jacobantoun/Christmas-Ornament-2024/3D/PTS815 Series.stp

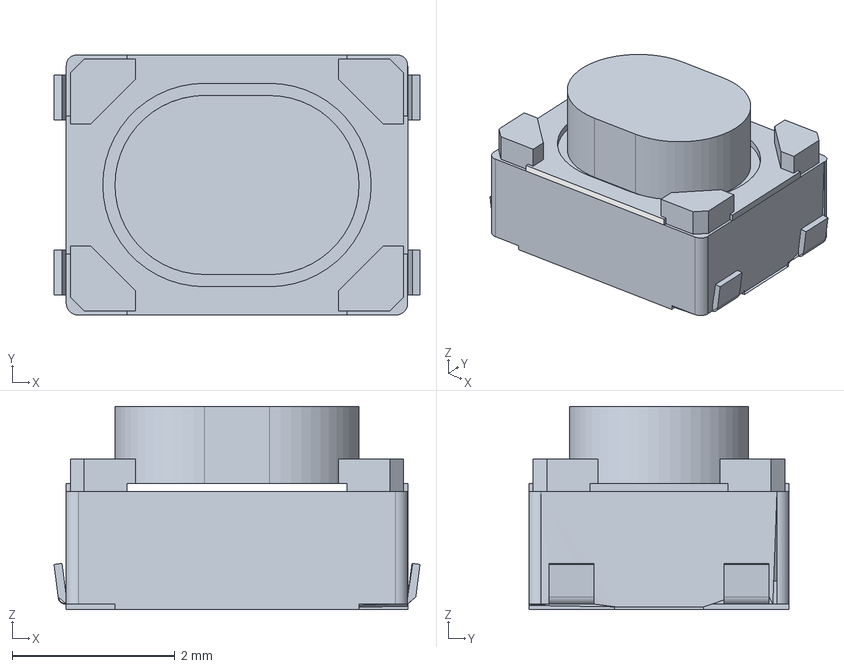
[picture p1: CAD file, 2024-11-22]
3D/PTS815 Series.stp
4.50 x 3.20 x 2.50 mm
PTS815SJM250SMTRLFS_PART1
PTS815SJM250SMTRLFS_PART2
PTS815SJM250SMTRLFS_PART3
