jacobantoun/Christmas-Ornament-2024/Christmas Ornament 2024.pdf

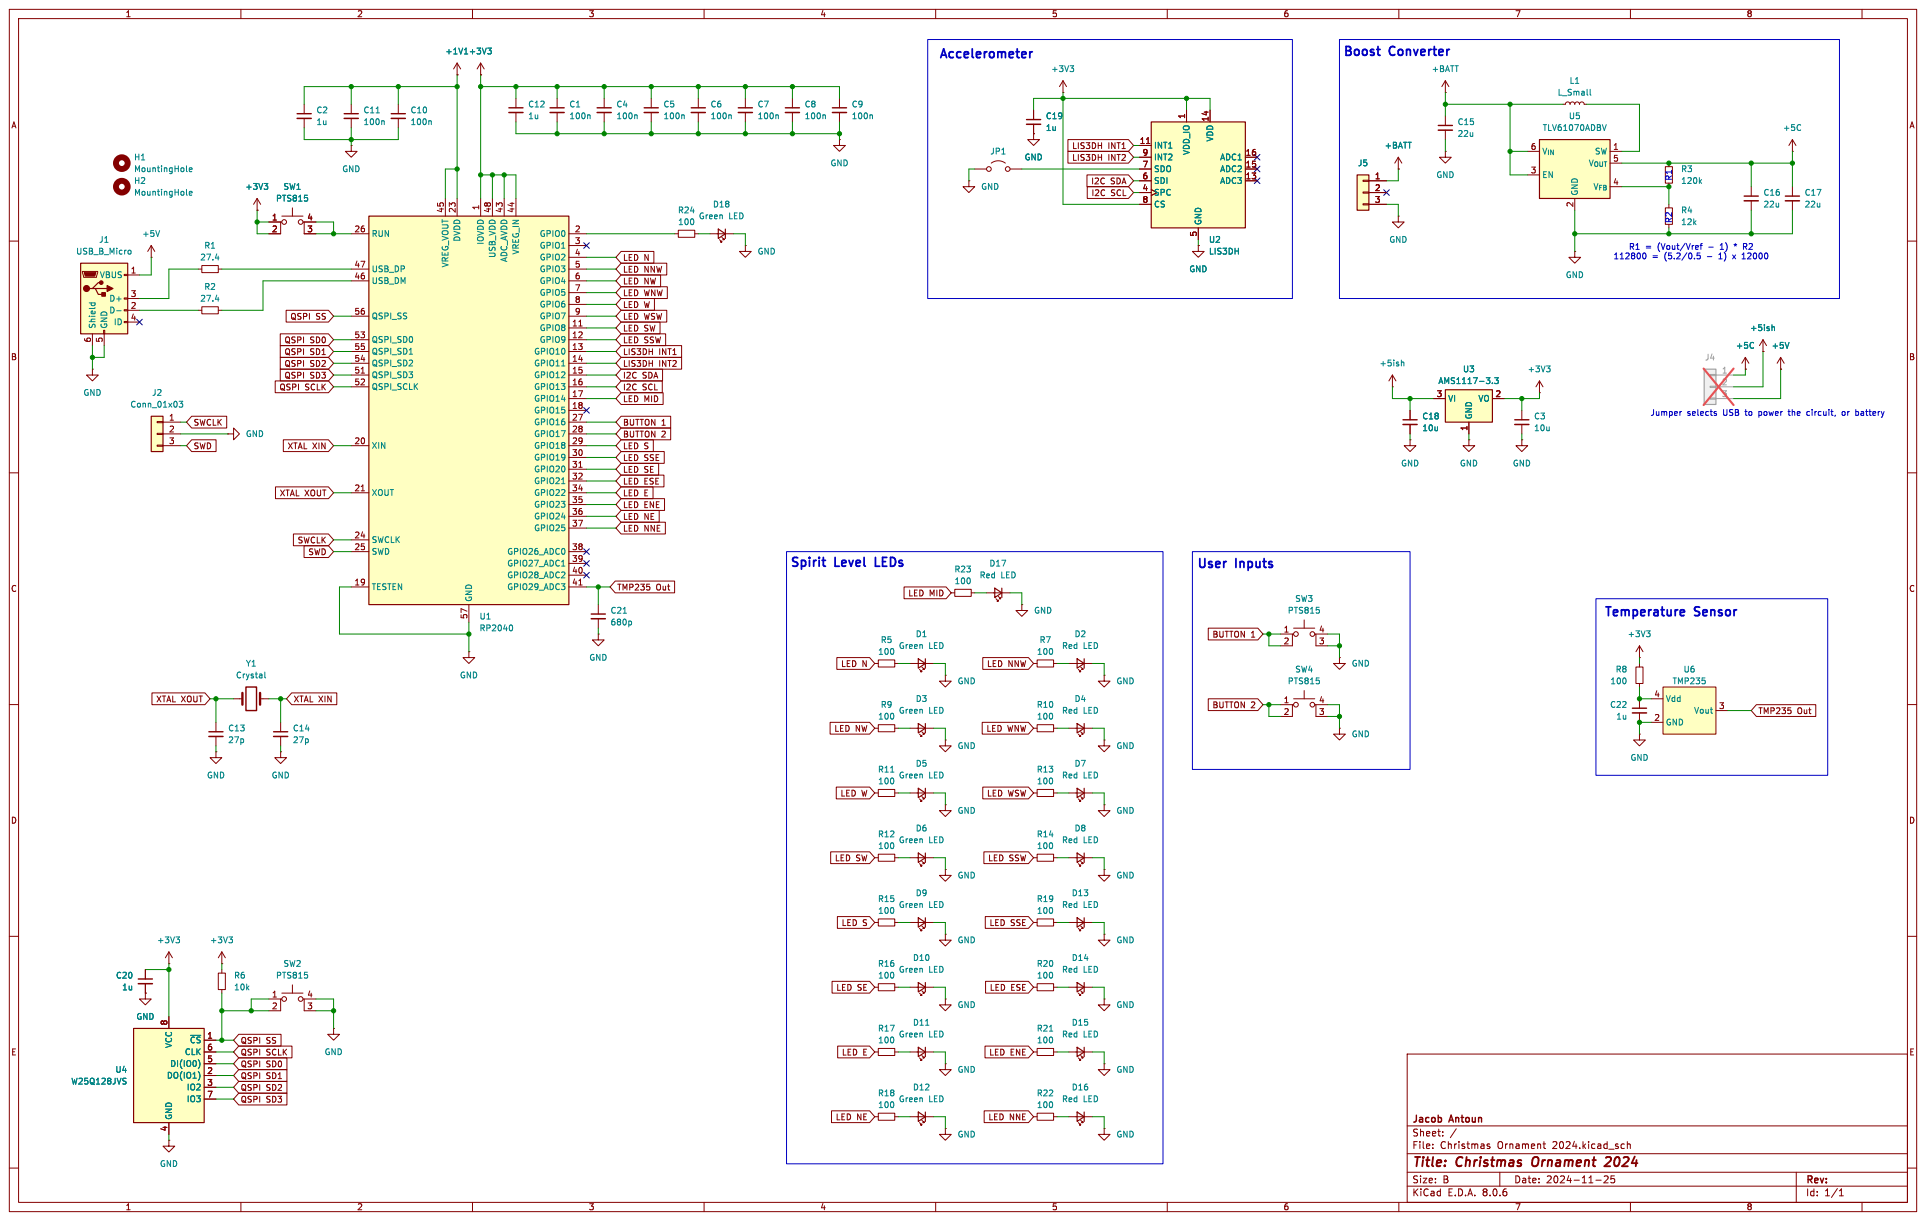
[picture p2: page 1]

2 EN 3 V_{FB}4 V_{OUT} 5 V_{IN} 6 U5 TLV61070ADBV

1 GPIO8 11 GPIO9 12 GPIO10 13 GPIO11 14 GPIO12 15 GPIO13 16 GPIO14 17 GPIO15 18 TESTEN 19 GPIO0 2 XIN 20 XOUT 21 DVDD 23 SWCLK 24 SWD 25 RUN 26 GPIO16 27 GPIO17 28 GPIO18 29 GPIO1 3 GPIO19 30 GPIO20 31 GPIO21 32 GPIO22 34 GPIO23 35 GPIO24 36 GPIO25 37 GPIO26_ADC0 38 GPIO27_ADC1 39 GPIO2 4 GPIO28_ADC2 40 GPIO29_ADC3 41 ADC_AVDD 43 VREG_IN 44 VREG_VOUT 45 USB_DM 46 USB_DP 47 USB_VDD 48 GPIO3 5 QSPI_SD3 51 QSPI_SCLK 52 QSPI_SD0 53 QSPI_SD2 54 QSPI_SD1 55 QSPI_SS 56 GND 57 GPIO4 6 GPIO5 7 GPIO6 8 GPIO7 9 U1 RP2040 D1 Green LED

LED MID QSPI SCLK QSPI SD1 QSPI SD3 QSPI SD0

LED NNE QSPI SD2 QSPI SS

Id: 1/1 Title: Christmas Ornament 2024
