jacobantoun/Christmas-Ornament-2024/Christmas Ornament 2024.kicad_pcb

## KiCad design Christmas Ornament 2024.kicad_pcb (2024-11-27)

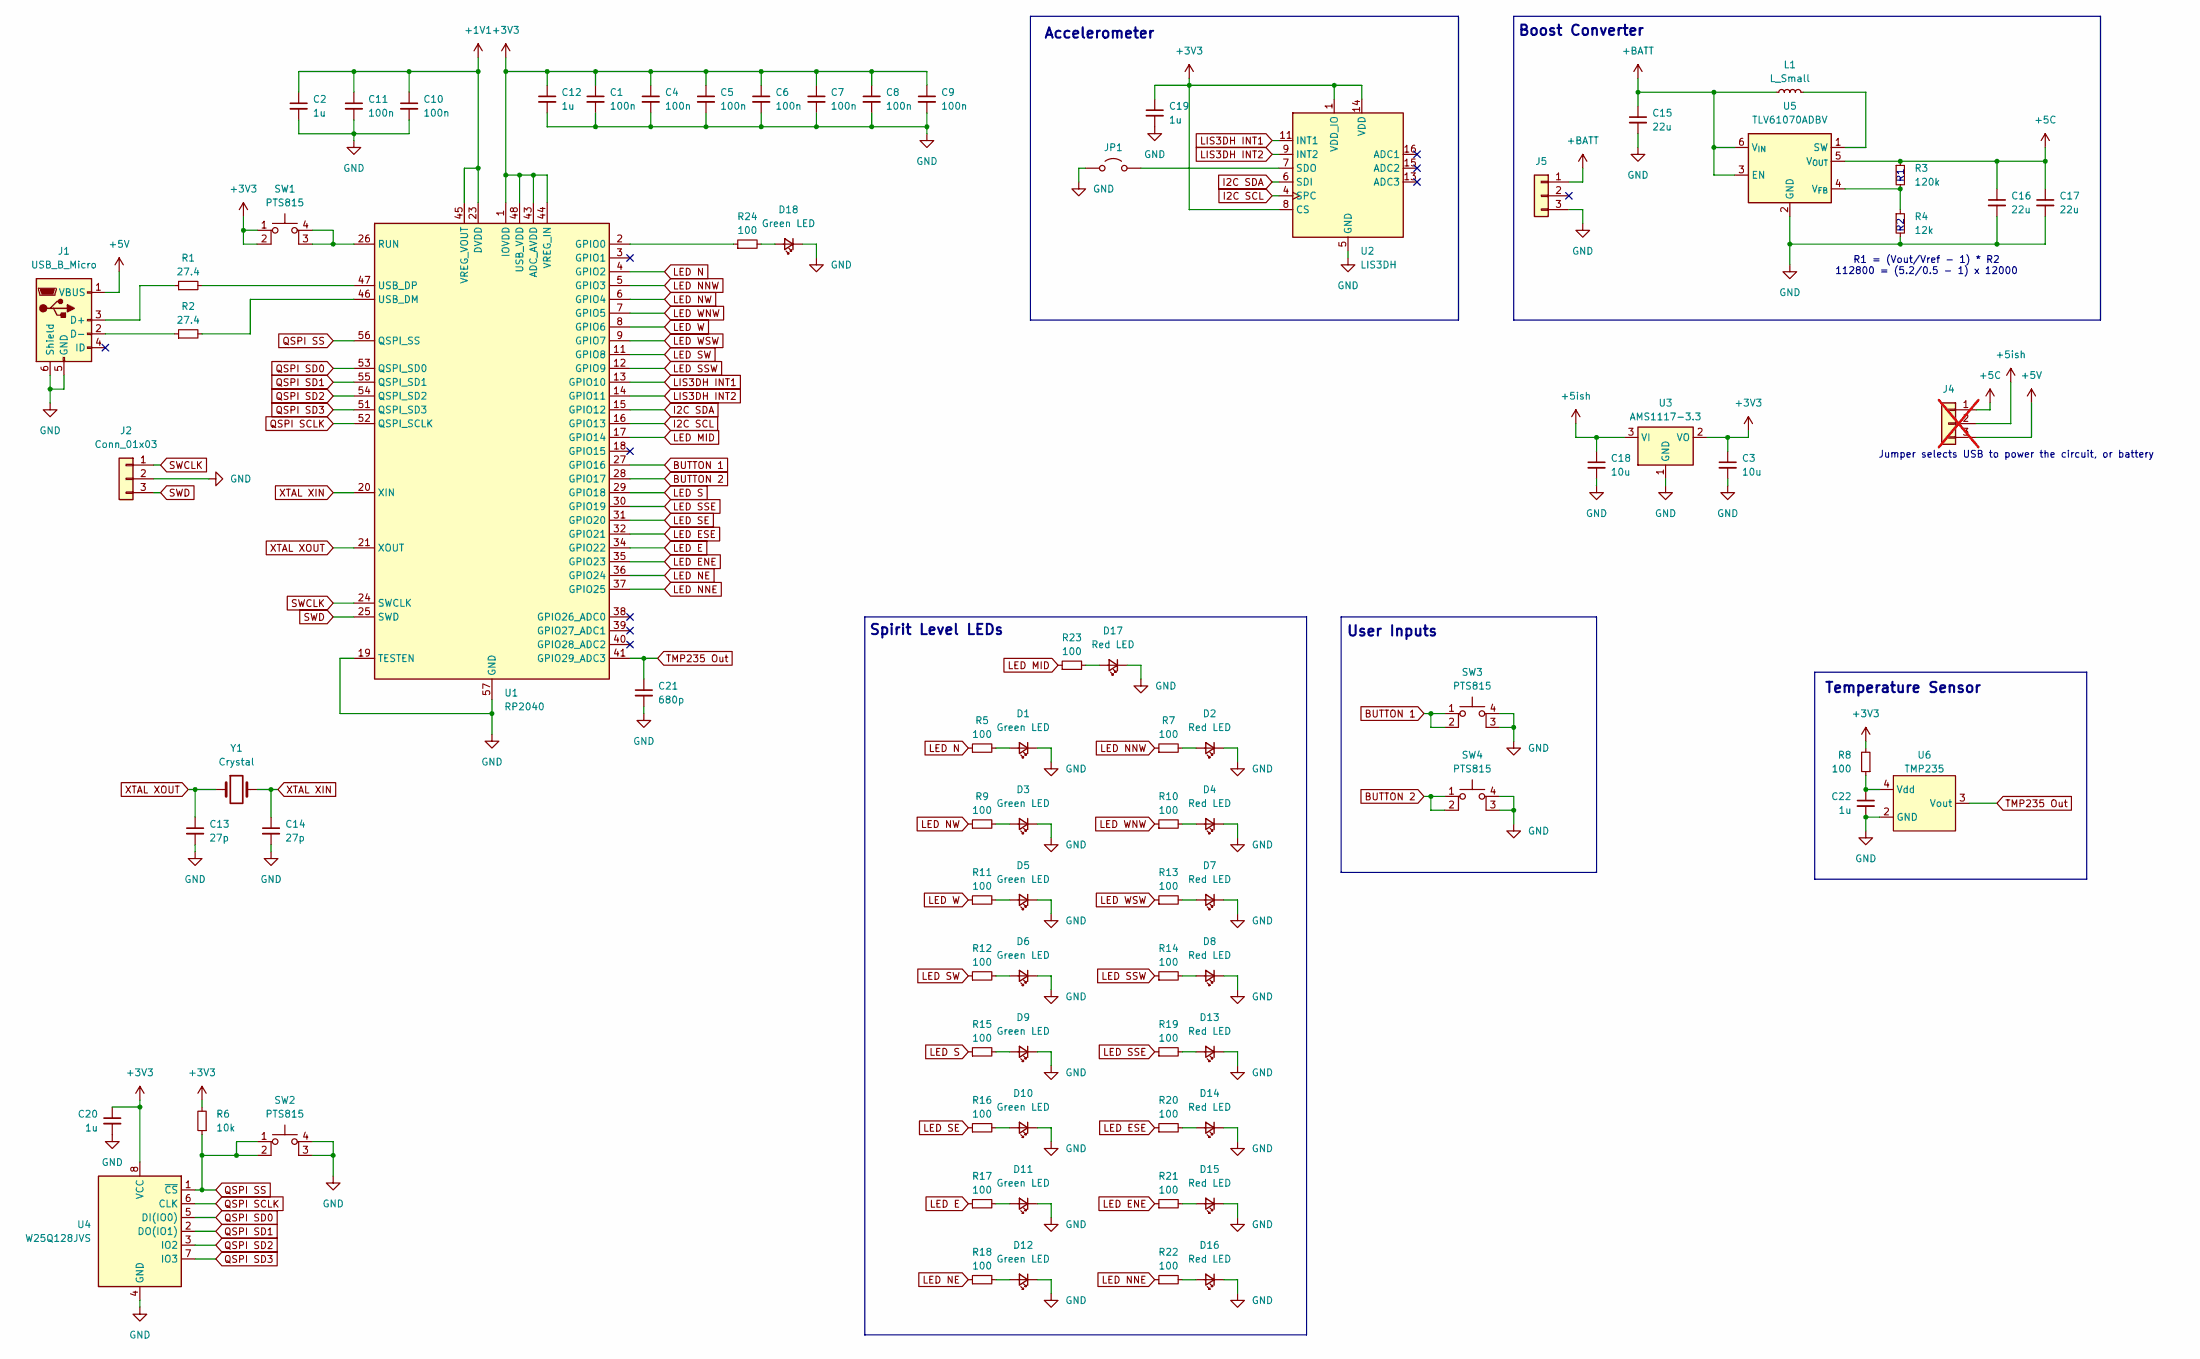
[picture p3: schematic Christmas Ornament 2024.kicad_sch]

Parts:
C1, C4, C5, C6, C7, C8, C9, C10, C11: 100n; C_0402_1005Metric_Pad0.74x0.62mm_HandSolder; JLCPCB PN C1525
C2, C12, C19, C20, C22: 1u; C_0402_1005Metric_Pad0.74x0.62mm_HandSolder; JLCPCB PN C52923
C3, C18: 10u; C_0805_2012Metric_Pad1.18x1.45mm_HandSolder; JLCPCB PN C15850
C13, C14: 27p; C_0402_1005Metric_Pad0.74x0.62mm_HandSolder; JLCPCB PN C1557
C15, C16, C17: 22u; C_0805_2012Metric_Pad1.18x1.45mm_HandSolder; JLCPCB PN C45783
C21: 680p; C_0603_1608Metric; JLCPCB PN C1630
D1, D3, D5, D6, D9, D10, D11, D12: Green LED; LED_0805_2012Metric_Pad1.15x1.40mm_HandSolder; JLCPCB PN C2297
D2, D4, D7, D8, D13, D14, D15, D16, D17: Red LED; LED_0805_2012Metric_Pad1.15x1.40mm_HandSolder; JLCPCB PN C2296
D18: Green LED; LED_0805_2012Metric_Pad1.15x1.40mm_HandSolder; JLCPCB PN C2296
J1: USB_B_Micro; USB_Micro-B_Amphenol_10103594-0001LF_Horizontal; JLCPCB PN C428495
J2: Conn_01x03; JST_SH_BM03B-SRSS-TB_1x03-1MP_P1.00mm_Vertical; JLCPCB PN C160389
J4: Conn_01x03; PinHeader_1x03_P2.54mm_Vertical; JLCPCB PN C49257; not fitted
J5: Conn_01x03; PinHeader_1x03_P2.54mm_Vertical; JLCPCB PN DNP
JP1: Jumper_2_Open; SolderJumper-2_P1.3mm_Open_RoundedPad1.0x1.5mm
L1: L_Small; L_Sunlord_SWPA3015S; JLCPCB PN C19734
R1, R2: 27.4; R_0402_1005Metric_Pad0.72x0.64mm_HandSolder; JLCPCB PN C274349
R3: 120k; R_0402_1005Metric; JLCPCB PN C93945
R4: 12k; R_0402_1005Metric; JLCPCB PN C25752
R5, R7, R8, R9, R10, R11, R12, R13, R14, R15, R16, R17, R18, R19, R20, R21, R22, R23, R24: 100; R_0805_2012Metric_Pad1.20x1.40mm_HandSolder; JLCPCB PN C17408
R6: 10k; R_0805_2012Metric_Pad1.20x1.40mm_HandSolder; JLCPCB PN C17414
SW1, SW2, SW3, SW4: PTS815; PTS815 Series; JLCPCB PN C411883
U1: RP2040; QFN-56-1EP_7x7mm_P0.4mm_EP3.2x3.2mm; JLCPCB PN C2040
U2: LIS3DH; LGA-16_3x3mm_P0.5mm_LayoutBorder3x5y; JLCPCB PN C15134
U3: AMS1117-3.3; SOT-223-3_TabPin2; JLCPCB PN C6186
U4: W25Q128JVS; SOIC-8_5.23x5.23mm_P1.27mm; JLCPCB PN C97521
U5: TLV61070ADBV; SOT-23-6; JLCPCB PN C6881375
U6: TMP235; SOT-353_SC-70-5; JLCPCB PN C2861437
Y1: Crystal; Crystal_SMD_Abracon_ABM3-2Pin_5.0x3.2mm; JLCPCB PN C148313

Connections:
+1V1: C2.1, C10.1, C11.1, U1.23 (DVDD), U1.45 (VREG_VOUT), U1.50 (DVDD)
+3V3: C1.1, C3.1, C4.1, C5.1, C6.1, C7.1, C8.1, C9.1, C12.1, C19.1, C20.1, R6.2, R8.2, SW1.1, SW1.2, U1.1 (IOVDD), U1.10 (IOVDD), U1.22 (IOVDD), U1.33 (IOVDD), U1.42 (IOVDD), U1.43 (ADC_AVDD), U1.44 (VREG_IN), U1.48 (USB_VDD), U1.49 (IOVDD), U2.1 (VDD_IO), U2.8 (CS), U2.14 (VDD), U3.2 (VO), U4.8 (VCC)
+5C: C16.1, C17.1, J4.1, R3.1, U5.5 (V_{OUT})
+5V: J1.1 (VBUS), J4.3
+5ish: C18.1, J4.2, U3.3 (VI)
+BATT: C15.1, J5.1, L1.1, U5.3 (EN), U5.6 (V_{IN})
BUTTON 1: SW3.1, SW3.2, U1.27 (GPIO16)
BUTTON 2: SW4.1, SW4.2, U1.28 (GPIO17)
GND: C1.2, C2.2, C3.2, C4.2, C5.2, C6.2, C7.2, C8.2, C9.2, C10.2, C11.2, C12.2, C13.2, C14.2, C15.2, C16.2, C17.2, C18.2, C19.2, C20.2, C21.2, C22.2, D1.1 (K), D2.1 (K), D3.1 (K), D4.1 (K), D5.1 (K), D6.1 (K), D7.1 (K), D8.1 (K), D9.1 (K), D10.1 (K), D11.1 (K), D12.1 (K), D13.1 (K), D14.1 (K), D15.1 (K), D16.1 (K), D17.1 (K), D18.1 (K), J1.5 (GND), J1.6 (Shield), J2.2, J5.3, JP1.1 (A), R4.2, SW2.3 (K), SW2.4 (A), SW3.3 (K), SW3.4 (A), SW4.3 (K), SW4.4 (A), U1.19 (TESTEN), U1.57 (GND), U2.5 (GND), U2.10 (GND), U2.12 (GND), U3.1 (GND), U4.4 (GND), U5.2 (GND), U6.2 (GND)
I2C SCL: U1.16 (GPIO13), U2.4 (SPC)
I2C SDA: U1.15 (GPIO12), U2.6 (SDI)
LED E: R17.1, U1.34 (GPIO22)
LED ENE: R21.1, U1.35 (GPIO23)
LED ESE: R20.1, U1.32 (GPIO21)
LED MID: R23.1, U1.17 (GPIO14)
LED N: R5.1, U1.4 (GPIO2)
LED NE: R18.1, U1.36 (GPIO24)
LED NNE: R22.1, U1.37 (GPIO25)
LED NNW: R7.1, U1.5 (GPIO3)
LED NW: R9.1, U1.6 (GPIO4)
LED S: R15.1, U1.29 (GPIO18)
LED SE: R16.1, U1.31 (GPIO20)
LED SSE: R19.1, U1.30 (GPIO19)
LED SSW: R14.1, U1.12 (GPIO9)
LED SW: R12.1, U1.11 (GPIO8)
LED W: R11.1, U1.8 (GPIO6)
LED WNW: R10.1, U1.7 (GPIO5)
LED WSW: R13.1, U1.9 (GPIO7)
LIS3DH INT1: U1.13 (GPIO10), U2.11 (INT1)
LIS3DH INT2: U1.14 (GPIO11), U2.9 (INT2)
unnamed: D1.2 (A), R5.2
unnamed: D2.2 (A), R7.2
unnamed: D3.2 (A), R9.2
unnamed: D4.2 (A), R10.2
unnamed: D5.2 (A), R11.2
unnamed: D6.2 (A), R12.2
unnamed: D7.2 (A), R13.2
unnamed: D8.2 (A), R14.2
unnamed: D9.2 (A), R15.2
unnamed: D10.2 (A), R16.2
unnamed: D11.2 (A), R17.2
unnamed: D12.2 (A), R18.2
unnamed: D13.2 (A), R19.2
unnamed: D14.2 (A), R20.2
unnamed: D15.2 (A), R21.2
unnamed: D16.2 (A), R22.2
unnamed: D17.2 (A), R23.2
unnamed: D18.2 (A), R24.2
unnamed: J1.3 (D+), R1.1
unnamed: J1.2 (D-), R2.1
unnamed: JP1.2 (B), U2.7 (SDO)
unnamed: SW1.3 (K), SW1.4 (A), U1.26 (RUN)
unnamed: R24.1, U1.2 (GPIO0)
unnamed: R2.2, U1.46 (USB_DM)
unnamed: R1.2, U1.47 (USB_DP)
unnamed: L1.2, U5.1 (SW)
unnamed: R3.2, R4.1, U5.4 (V_{FB})
unnamed: C22.1, R8.1, U6.4 (Vdd)
QSPI SCLK: U1.52 (QSPI_SCLK), U4.6 (CLK)
QSPI SD0: U1.53 (QSPI_SD0), U4.5 (DI(IO0))
QSPI SD1: U1.55 (QSPI_SD1), U4.2 (DO(IO1))
QSPI SD2: U1.54 (QSPI_SD2), U4.3 (IO2)
QSPI SD3: U1.51 (QSPI_SD3), U4.7 (IO3)
QSPI SS: R6.1, SW2.1, SW2.2, U1.56 (QSPI_SS), U4.1 (~CS)
SWCLK: J2.1, U1.24 (SWCLK)
SWD: J2.3, U1.25 (SWD)
TMP235 Out: C21.1, U1.41 (GPIO29_ADC3), U6.3 (Vout)
XTAL XIN: C14.1, U1.20 (XIN), Y1.2
XTAL XOUT: C13.1, U1.21 (XOUT), Y1.1

Notes on the sheet:
Temperature Sensor
Boost Converter
Accelerometer
Spirit Level LEDs
Jumper selects USB to power the circuit, or battery
R1 = (Vout/Vref - 1) * R2 112800 = (5.2/0.5 - 1) x 12000
User Inputs

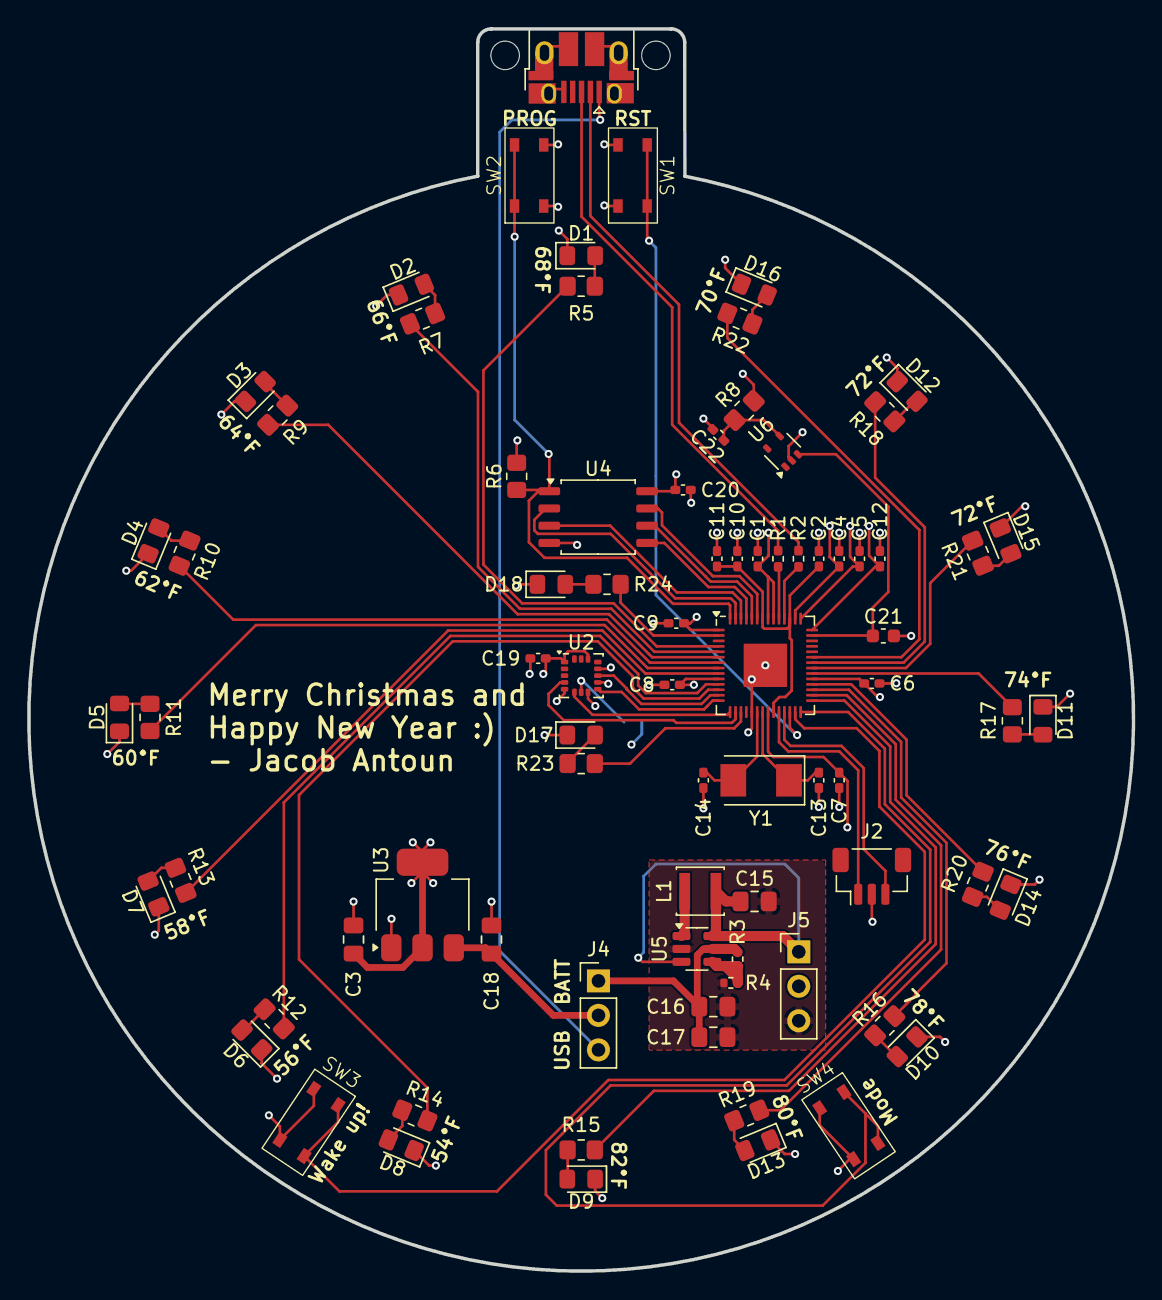
[picture p4: board Christmas Ornament 2024.kicad_pcb from above]

Board: 4 copper layers, 81.3 x 91.5 mm, 83 parts (1 on the bottom side), 69 nets.

Other parts of the board:
H1, H2: MountingHole; MountingHole_2.1mm
