jacobantoun/Christmas-Ornament-2024/(commit log)

2024-11-21 Update Christmas Ornament 2024.kicad_sch
    [Christmas Ornament 2024.kicad_sch]
2024-11-22 Add LEDs and resistors
    [Christmas Ornament 2024.kicad_sch]
2024-11-22 Schematic Finished
    [Christmas Ornament 2024.kicad_sch, PTS815 Series.stp]
2024-11-22 Ready for Layout
    [Christmas Ornament 2024.kicad_sch]
2024-11-23 PCB Layout beginning
    [Christmas Ornament 2024.kicad_pcb, Christmas Ornament 2024.kicad_sch]
2024-11-23 Changed feedback resistor sizes
2024-11-24 Layout in progress...
    [Christmas Ornament 2024.kicad_pcb, Christmas Ornament 2024.kicad_sch]
2024-11-25 PCB Layout and Routing complete
    DRC
    [Christmas Ornament 2024.kicad_pcb, Christmas Ornament 2024.kicad_sch]
2024-11-26 Silkscreen in progress
    [Christmas Ornament 2024.kicad_pcb]
2024-11-26 BOM and Gerber export
    [Christmas Ornament 2024-B_Cu.gbr, Christmas Ornament 2024-B_Mask.gbr, Christmas Ornament 2024-B_Paste.gbr, Christmas Ornament 2024-B_Silkscreen.gbr, Christmas Ornament 2024-Edge_Cuts.gbr, Christmas Ornament 2024-F_Cu.gbr, Christmas Ornament 2024-F_Mask.gbr, Christmas Ornament 2024-F_Paste.gbr]
2024-11-26 deleted gerbers not in folder
    [Christmas Ornament 2024-B_Cu.gbr, Christmas Ornament 2024-B_Mask.gbr, Christmas Ornament 2024-B_Paste.gbr, Christmas Ornament 2024-B_Silkscreen.gbr, Christmas Ornament 2024-Edge_Cuts.gbr, Christmas Ornament 2024-F_Cu.gbr, Christmas Ornament 2024-F_Mask.gbr, Christmas Ornament 2024-F_Paste.gbr]
2024-11-26 BOM and CPL ready for ordering
    [Christmas Ornament 2024-B_Cu.gbr, Christmas Ornament 2024-B_Mask.gbr, Christmas Ornament 2024-B_Paste.gbr, Christmas Ornament 2024-B_Silkscreen.gbr, Christmas Ornament 2024-Edge_Cuts.gbr, Christmas Ornament 2024-F_Cu.gbr, Christmas Ornament 2024-F_Mask.gbr, Christmas Ornament 2024-F_Paste.gbr]
2024-12-12 Added temp F
    Temperature seems to be off by a few degrees...
2024-12-15 Added spirit level and temperature functionality
2024-12-15 kicad save
2024-12-17 Added mode switching
    Need to add PWM to temperature LEDs
2024-12-20 Create pico extras
