jacobantoun/Christmas-Ornament-2024/(notices)

Notices in the files:
3D/PTS815 Series.stp:
author */ ('License CC BY-ND 4.0'),
